aapatni/climb-sense-hold/3651 Final Presentation.pdf

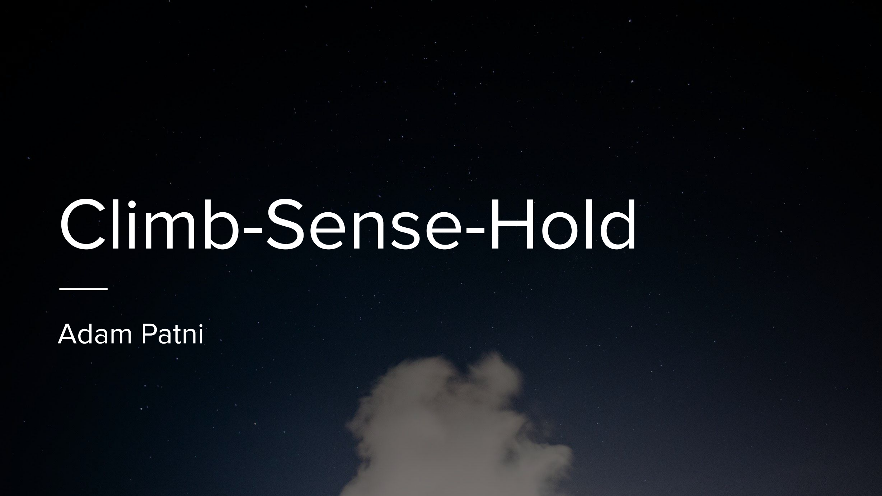
[picture p13: page 1]

# Climb-Sense-Hold

## Adam Patni

# Problem Statement

## - Develop climbing holds that can sense when someone has grabbed them - Use Case - moon boards for training - Use Case - auto belay systems

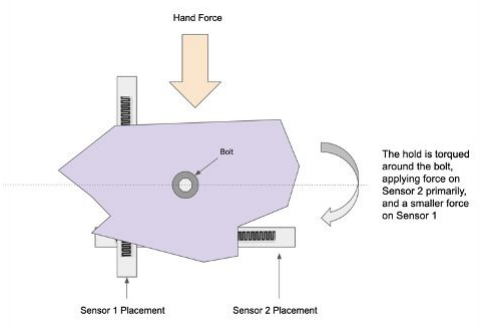
[picture p14: figure]

# Prototyping

- Hard to orient
- Depends on tightness
of bolt

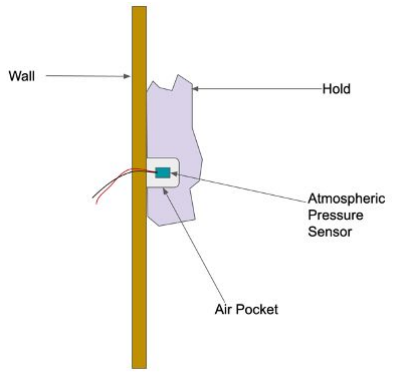
[picture p15: figure]

# Prototyping

- No good way to seal
off air pocket
- Material does not
compress enough to
notice a change

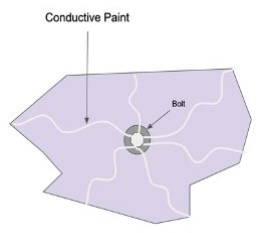
[picture p16: figure]

# Prototyping

- Minimizes the amount of
extra hardware on the wall
- Hard to make hold
conductive - had to use
conductive paint

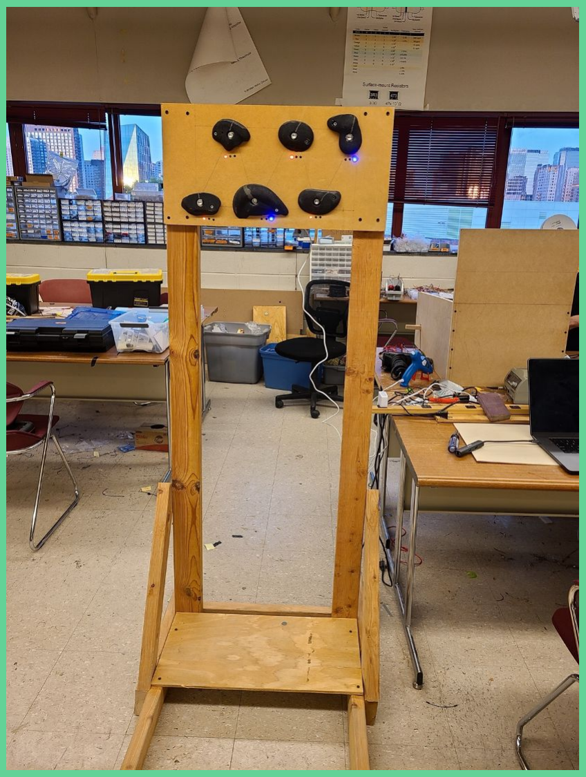
[picture p17: figure]

# Live Demo!

# Lessons Learned + Future Work

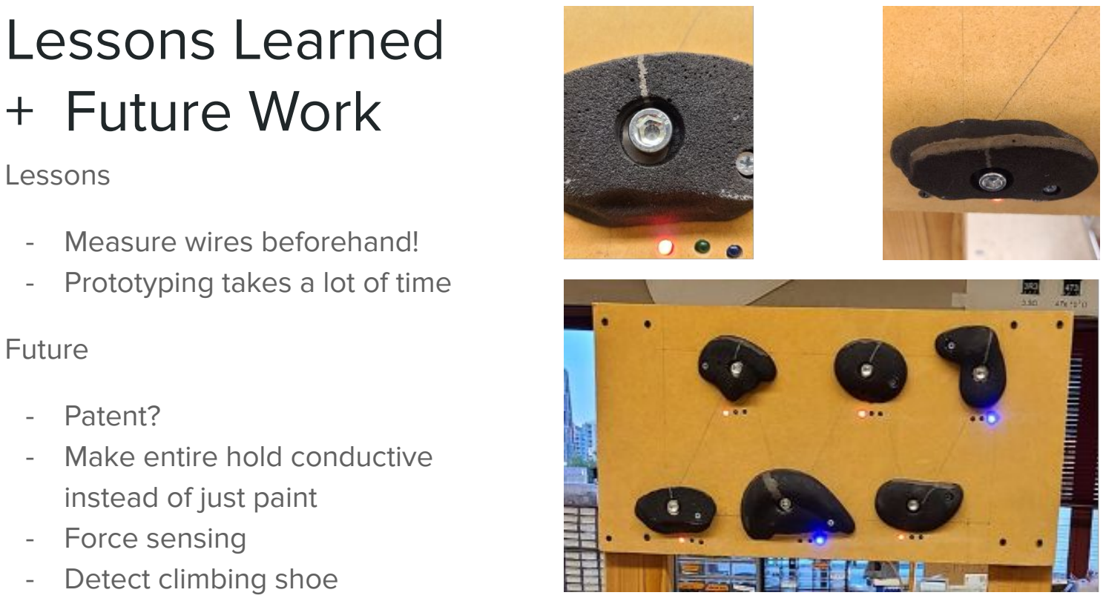
[picture p18: page 7]

Lessons

- Measure wires beforehand!
- Prototyping takes a lot of time

Future

- Patent?
- Make entire hold conductive instead of just paint
- Force sensing
- Detect climbing shoe
