aapatni/climb-sense-hold/Project_Mega_AtmosphericPressure_Prototype/Project_Mega_AtmosphericPressure_Prototype.ino

/*  Arduino Tutorial - Testing the Adafruits BMP280 Presure & Temperature Sensor
  I2C Connection: Vin: 5V/3V, GND: GND, SCK: A5 (SCL), SDI: A4 (SDA) 
  Dev: Michalis Vasilakis // Date: 8/3/206 // Info: www.ardumotive.com    */
  
#include <Wire.h>
#include "SPI.h" //Why? Because library supports SPI and I2C connection
#include <Adafruit_Sensor.h>
#include "Adafruit_BMP280.h"

//Setup connection of the sensor
Adafruit_BMP280 bmp; // I2C
/*//For SPI connection!
#define BMP_SCK 13
#define BMP_MISO 12
#define BMP_MOSI 11 
#define BMP_CS 10
//Adafruit_BMP280 bme(BMP_CS); // hardware SPI
//Adafruit_BMP280 bme(BMP_CS, BMP_MOSI, BMP_MISO,  BMP_SCK);
*/

//Variables
float pressure;   //To store the barometric pressure (Pa)
float temperature;  //To store the temperature (oC)
int altimeter;    //To store the altimeter (m) (you can also use it as a float variable)

void setup() {
  bmp.begin();    //Begin the sensor
    Serial.begin(9600); //Begin serial communication at 9600bps
    Serial.println("Adafruit BMP280 test:");
}

void loop() {
  //Read values from the sensor:
  pressure = bmp.readPressure();
  temperature = bmp.readTemperature();
  altimeter = bmp.readAltitude(1019.64); //Change the "1050.35" to your city current barrometric pressure (https://www.wunderground.com)
  
  //Print values to serial monitor:
  Serial.print(F("Pressure: "));
    Serial.print(pressure);
    Serial.print(" Pa");
    Serial.print("\t");
    Serial.print(("Temp: "));
    Serial.print(temperature);
    Serial.print(" oC");
  Serial.print("\t");
    Serial.print("Altimeter: ");
    Serial.print(altimeter); // this should be adjusted to your local forcase
    Serial.println(" m");
    
    delay(5000); //Update every 5 sec
}
